gorkemguven/LattePanda-Mu-Lite-Custom-Carrier/bom.csv

Designator | Footprint | Quantity | Value | LCSC Part #
A1 | LattePanda_Module_H8.0mm_Horizontal | 1 | LattePanda_Mu
BT1 | Battery_Holder_CR1220_S8411-45R | 1 | Battery_Cell
C17, C18, C19, C20, C21, C22, C23, C24, C25, C26, C27, C28, C29, C33, C34, C35, C36, C37, C38, C39, C40, C41, C42, C43, C45, C48, C52, C54, C58, C60, C84 | 0402 | 31 | 100nF/50V
C30, C31, C32, C64, C65, C67, C68, C74, C75, C76, C77, C80, C81, C82, C83 | 0603 | 15 | 22uF/10V
C44, C51, C53, C57, C59 | 0402 | 5 | 10uF/50V
C46, C47, C73 | 0402 | 3 | 12pF/50V
C49, C50, C55, C56 | 0402 | 4 | 220nF/50V
C61, C66, C69 | 0402 | 3 | 1uF/16V
C70, C71 | 0603 | 2 | 100nF/50V
C78, C79 | 0603 | 2 | 100nF/10V
D1, D2, D3 | 0402 | 3 | ESD5V0B03
D10, D11, D21, D25, D5, D6, D7, D8 | 0402 | 8 | ESD9B5.0ST5G
D12, D13, D14 | 0402 | 3 | D_Zener
D15, D16, D17, D18, D19, D20 | D_SMA | 6 | D_Schottky
D22 | 0603 | 1 | LED
D24 | D_SOD-323 | 1 | 3V3 Izt=5mA
D26, D4 | D_SOD-323 | 2 | 1N5819WS
D9 | 0603 | 1 | LED_G
F1 | 0603 | 1 | 6V/50mA
F2, F3, F4, F5 | 0805 | 4 | 6V/1A
J1, J10, J11, J14, J8 | PinHeader_1x03_P2.54mm_Vertical | 5 | Conn_01x03_Pin
J12, J13, J19, J20, J21, J7, J9 | PinHeader_1x04_P2.54mm_Vertical | 7 | Conn_01x04_Pin
J15 | PCIe_M.2_Connectors_P=0.5mm_H=4.2mm_KeyM | 1 | Bus_M.2_Socket_M
J16 | PCIe_M.2_Connectors_P=0.5mm_H=4.2mm_KeyE | 1 | Bus_M.2_Socket_E
J17 | DC_Jack_DC007B_30V_10A | 1 | Barrel_Jack_Switch
J18 | USB_C_Receptacle_G-Switch_GT-USB-7010ASV | 1 | USB_C_Receptacle_USB2.0_16P
J3 | HDMI_A_Molex_208658-1001_Horizontal | 1 | HDMI_A
J4 | USB3_A_Molex_48406-0001_Horizontal_Stacked | 1 | USB3_A_Stacked
J5 | USB_A_CUI_UJ2-ADH-TH_Horizontal_Stacked | 1 | USB_A_Stacked
J6 | RJ45_UDE_RB1-125B8G1A | 1 | RJ45_RB1-125B8G1A
L1, L2 | L_Sunlord_SWPA4020S | 2 | 2.2uH/4.3A
M1 | JST_PH_B4B-PH-K_1x04_P2.00mm_Vertical | 1 | Fan_4pin
Q1, Q8 | SOT-23 | 2 | 2N7002
Q2, Q3, Q4 | SOT-23 | 3 | 2SK3018
R1, R11, R37, R47 | 0402 | 4 | 1K/1%
R10, R13, R14, R16, R17, R24, R25, R7, R8, R9 | 0402 | 10 | 470R/1%
R15, R18, R19, R3, R5, R52, R53 | 0402 | 7 | 2.2K/1%
R2, R20, R21, R34, R35, R36, R49, R58, R78, R79 | 0402 | 10 | 10K/1%
R22 | 0603 | 1 | 2.49K/1%
R23, R4 | 0402 | 2 | 1M/1%
R27, R29, R32, R33 | 0402 | 4 | 0R/1%
R43 | 0402 | 1 | 56K/1%
R46, R51, R76, R77 | 0402 | 4 | 100K/1%
R48, R55, R69 | 0402 | 3 | 100R/1%
R57 | 0402 | 1 | 75K/1%
R59, R6, R68 | 0402 | 3 | 21.5K/1%
R60, R72 | 0402 | 2 | 4.7K/1%
SW1, SW2 | SW_Push_6x6x6 | 2 | SW_Push
TP10, TP11, TP12, TP13, TP2, TP3, TP4, TP5, TP6, TP7 | TestPoint_Pad_D1.5mm | 10 | TestPoint
U1, U2, U3, U4, U5 | Diodes_UDFN-10_1.0x2.5mm_P0.5mm | 5 | D3V3XA4B10LP
U10, U11, U12, U17, U9 | Diodes_UDFN-10_1.0x2.5mm_P0.5mm | 5 | ULC0524P
U14 | ESSOP-10-1EP_3.9x5mm_P1.0mm_EP3.2x2.3 | 1 | USB PD等快充协议受电芯片-CH224K-ESSOP10
U15, U16 | TSOT-23-6 | 2 | LM2734X
U6 | QFN-32-1EP_4x4mm_P0.4mm_EP2.65x2.65mm | 1 | RTL8111H-CG-RH
Y1 | Crystal_SMD_3225-4Pin_3.2x2.5mm | 1 | 25MHz
