gorkemguven/LattePanda-Mu-Lite-Custom-Carrier/LattePandaMu_carrier_custom_Sch.pdf

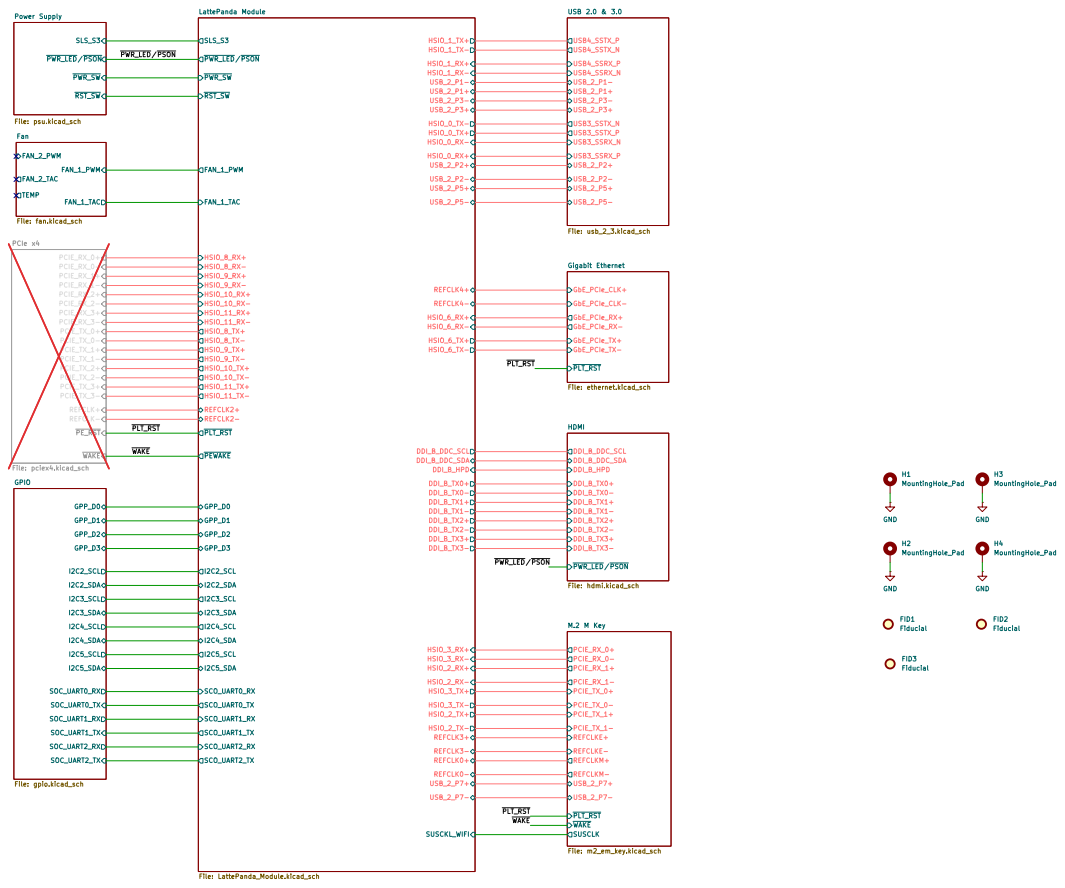
[picture p8: page 1]

Size: A2 | Rev: 1
KiCad E.D.A. 10.0.1 | Id: 1/10

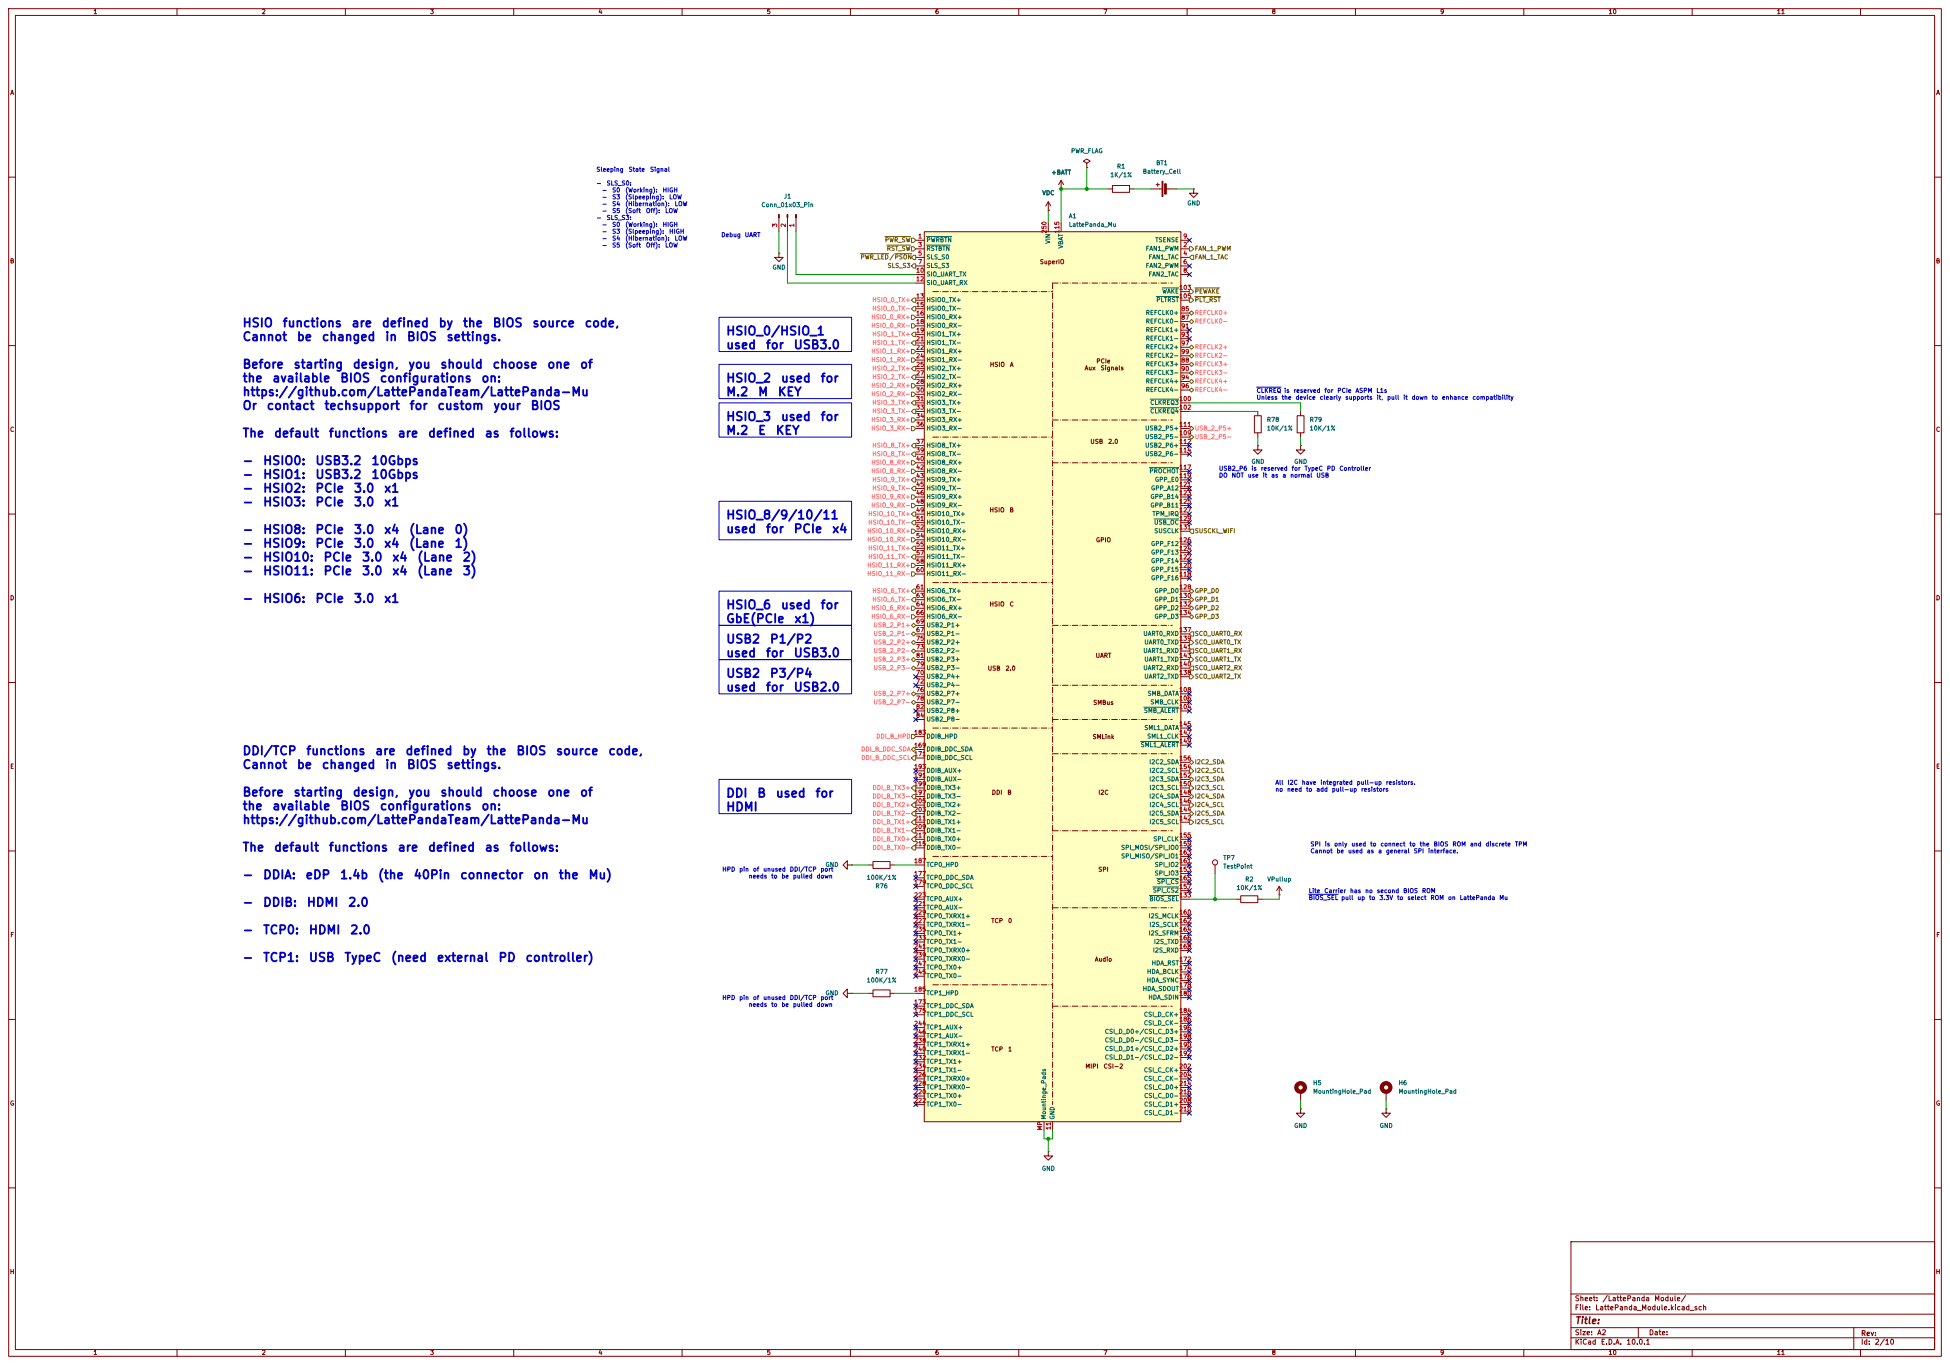
[picture p9: page 2]

Sleeping State Signal - SLS_S0: - S0 (Working): HIGH - S3 (Slpeeping): LOW - S4 (Hibernation): LOW - S5 (Soft Off): LOW - SLS_S3: - S0 (Working): HIGH - S3 (Slpeeping): HIGH - S4 (Hibernation): LOW - S5 (Soft Off): LOW HSIO functions are defined by the BIOS source code,

CLKREQ is reserved for PCIe ASPM L1s Unless the device clearly supports it, pull it down to enhance compatibility +BATT VDC

Cannot be changed in BIOS settings.

Before starting design, you should choose one of
the available BIOS configurations on:
https://github.com/LattePandaTeam/LattePanda-Mu
Or contact techsupport for custom your BIOS

HSIO A HSIO B HSIO C USB 2.0 DDI B

The default functions are defined as follows: - HSIO0: USB3.2 10Gbps - HSIO1: USB3.2 10Gbps - HSIO2: PCIe 3.0 x1 - HSIO3: PCIe 3.0 x1 - HSIO8: PCIe 3.0 x4 (Lane 0) - HSIO9: PCIe 3.0 x4 (Lane 1) - HSIO10: PCIe 3.0 x4 (Lane 2) - HSIO11: PCIe 3.0 x4 (Lane 3) - HSIO6: PCIe 3.0 x1

USB2_P6 is reserved for TypeC PD Controller DO NOT use it as a normal USB

HPD pin of unused DDI/TCP port needs to be pulled down DDI/TCP functions are defined by the BIOS source code,

All I2C have integrated pull-up resistors. no need to add pull-up resistors SPI is only used to connect to the BIOS ROM and discrete TPM

The default functions are defined as follows: - DDIA: eDP 1.4b (the 40Pin connector on the Mu) - DDIB: HDMI 2.0 - TCP0: HDMI 2.0 - TCP1: USB TypeC (need external PD controller)

Cannot be used as a general SPI interface.

BIOS_SEL pull up to 3.3V to select ROM on LattePanda Mu HPD pin of unused DDI/TCP port needs to be pulled down

Lite Carrier has no second BIOS ROM

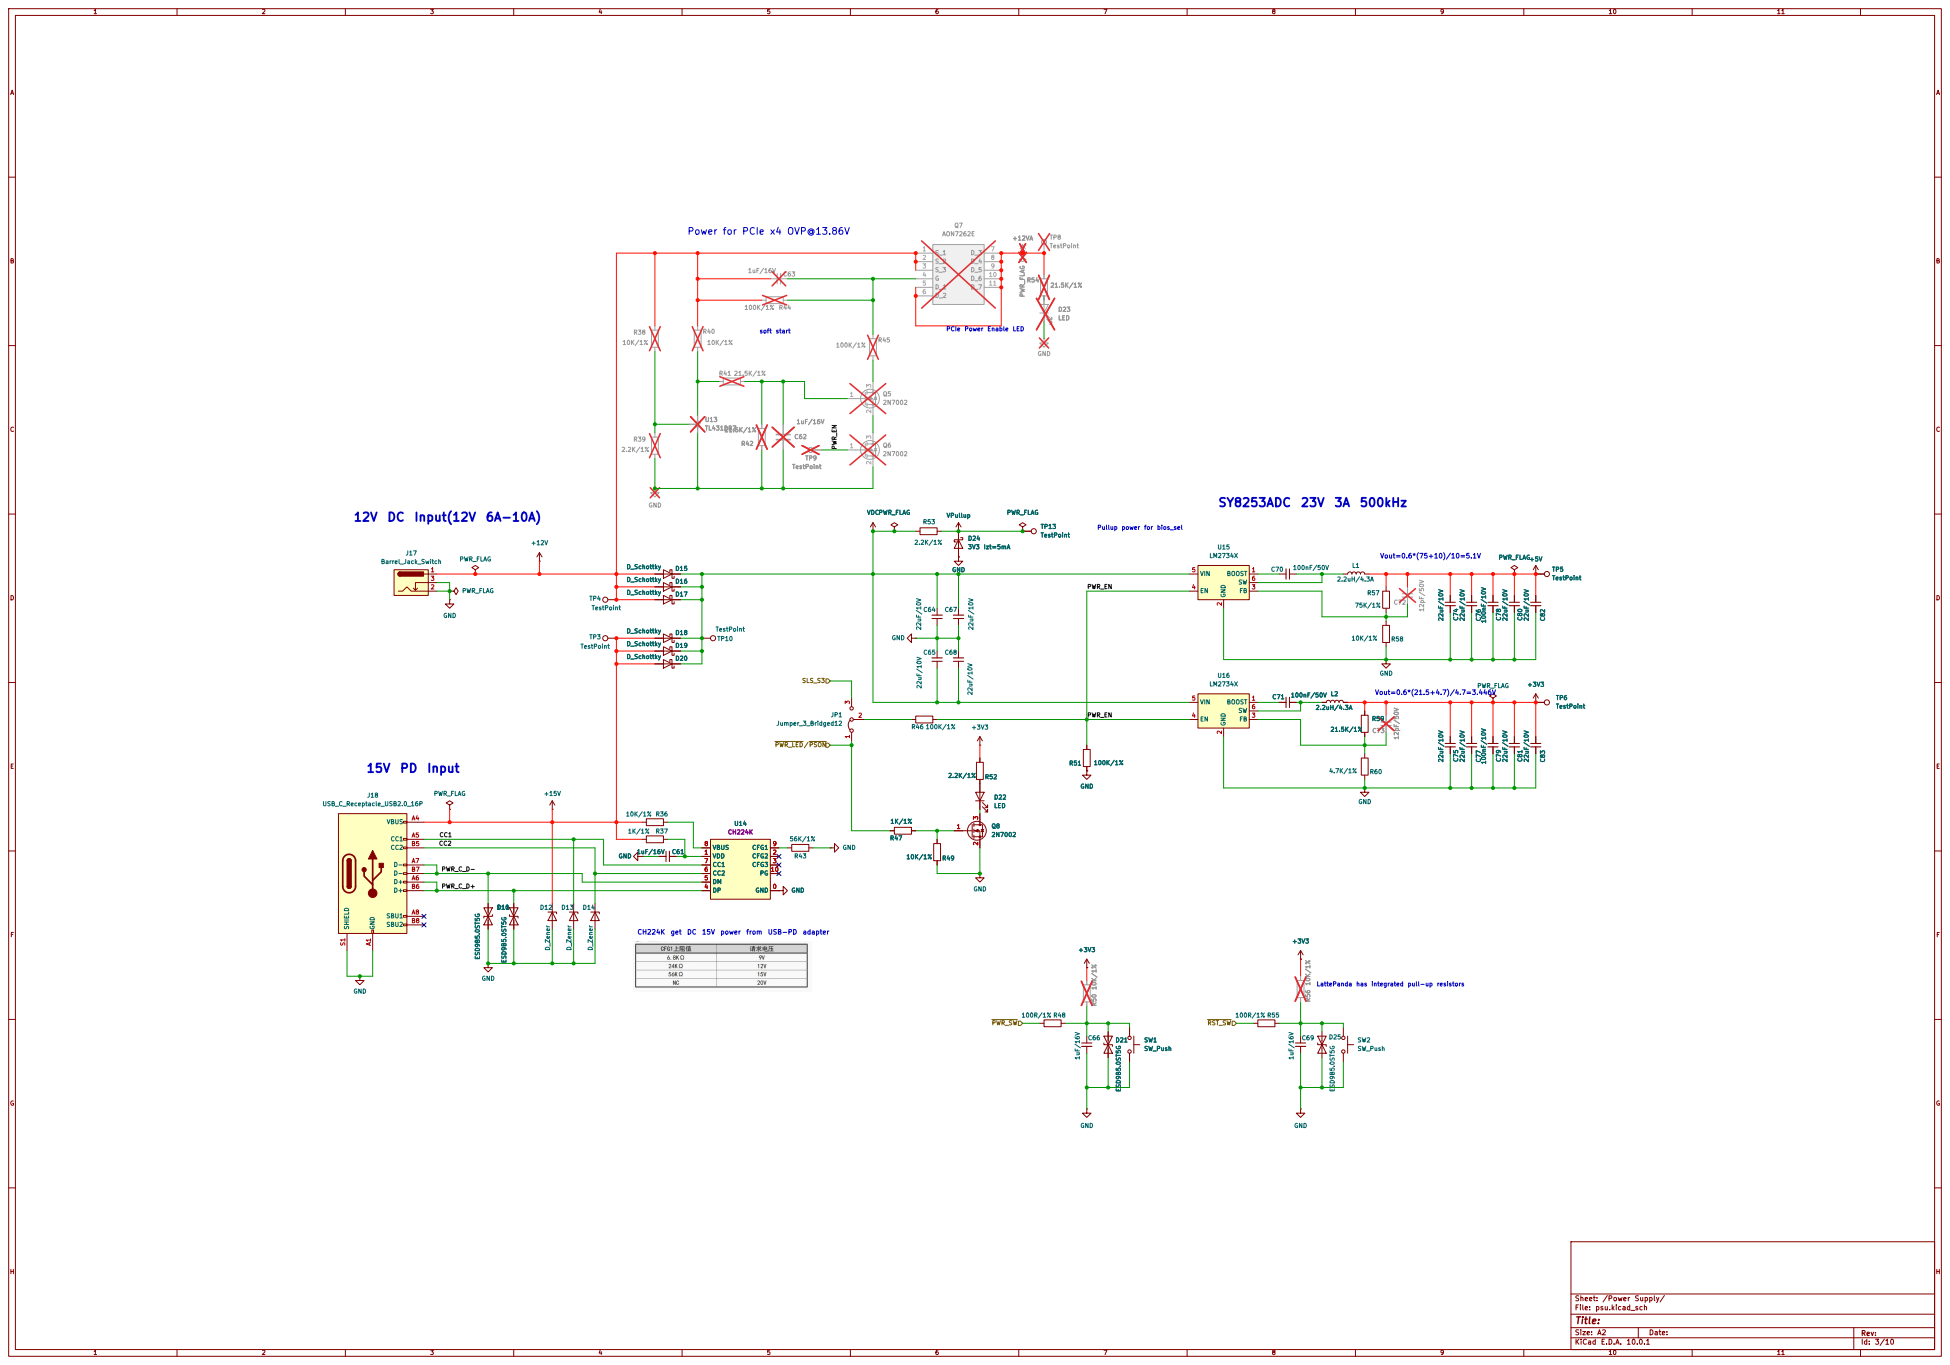
[picture p10: page 3]

Power for PCIe x4 OVP@13.86V

PCIe Power Enable LED 15V PD Input

LattePanda has integrated pull-up resistors SY8253ADC 23V 3A 500kHz

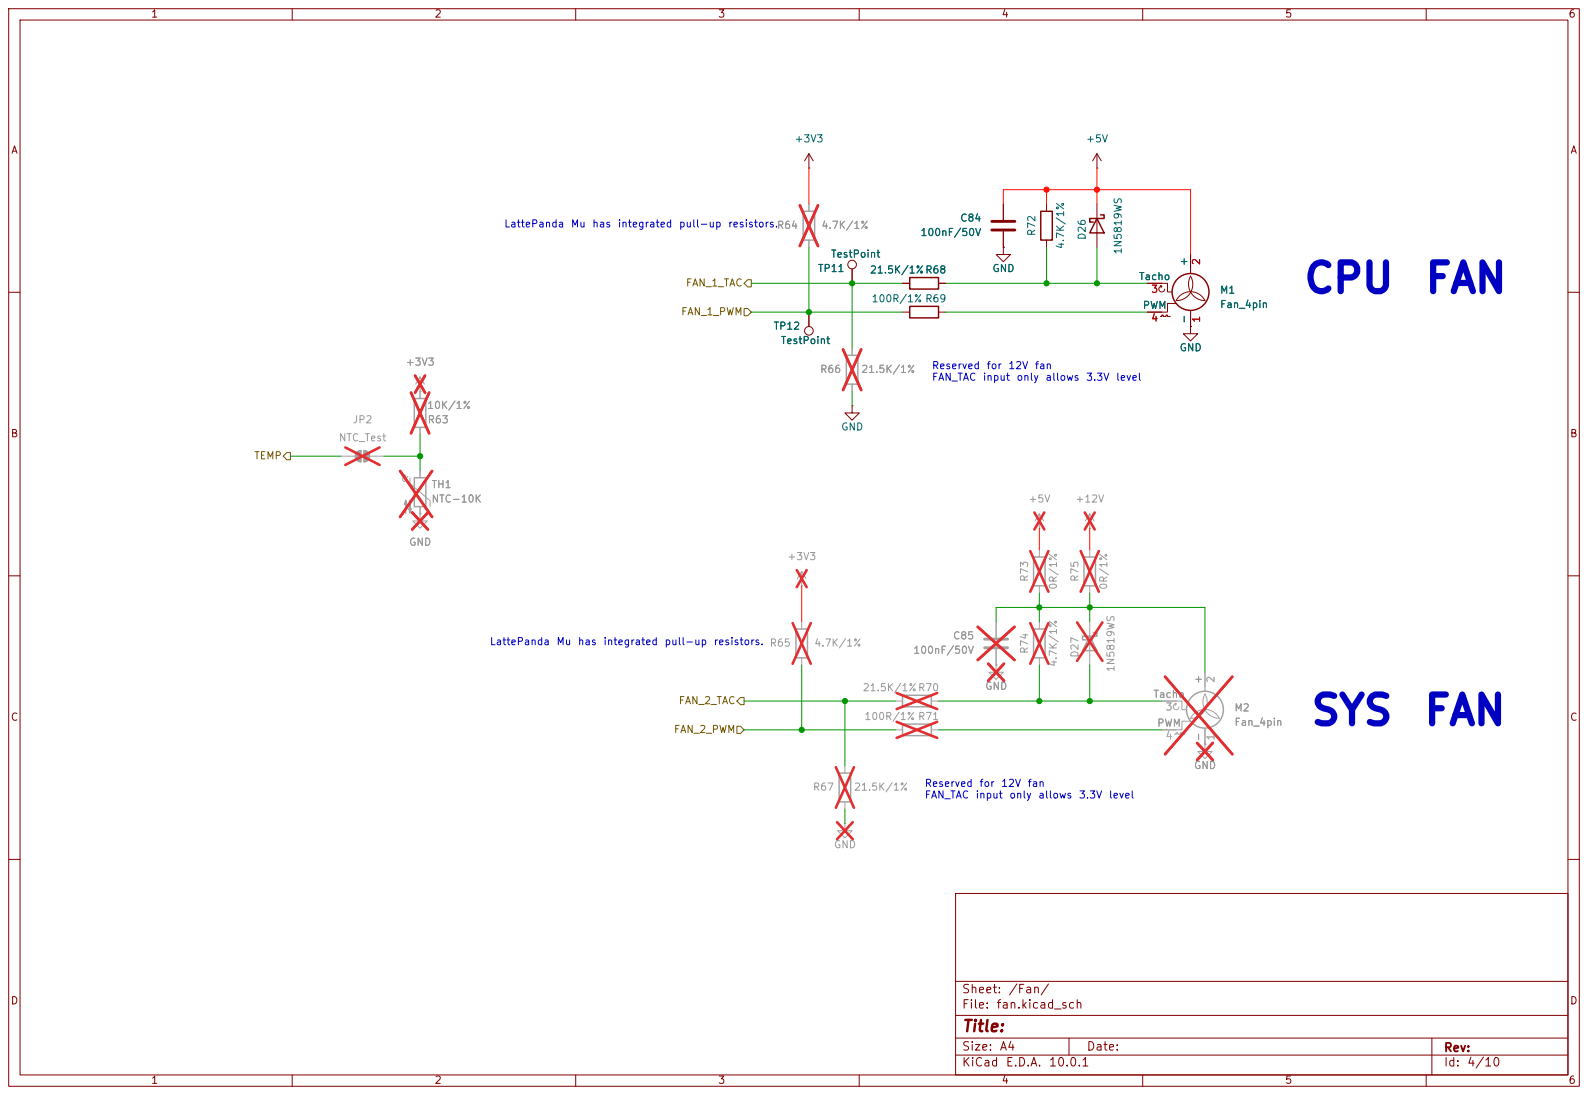
[picture p11: page 4]

Fan_4pin +5V GND
4 GND
FAN_TAC input only allows 3.3V level Reserved for 12V fan

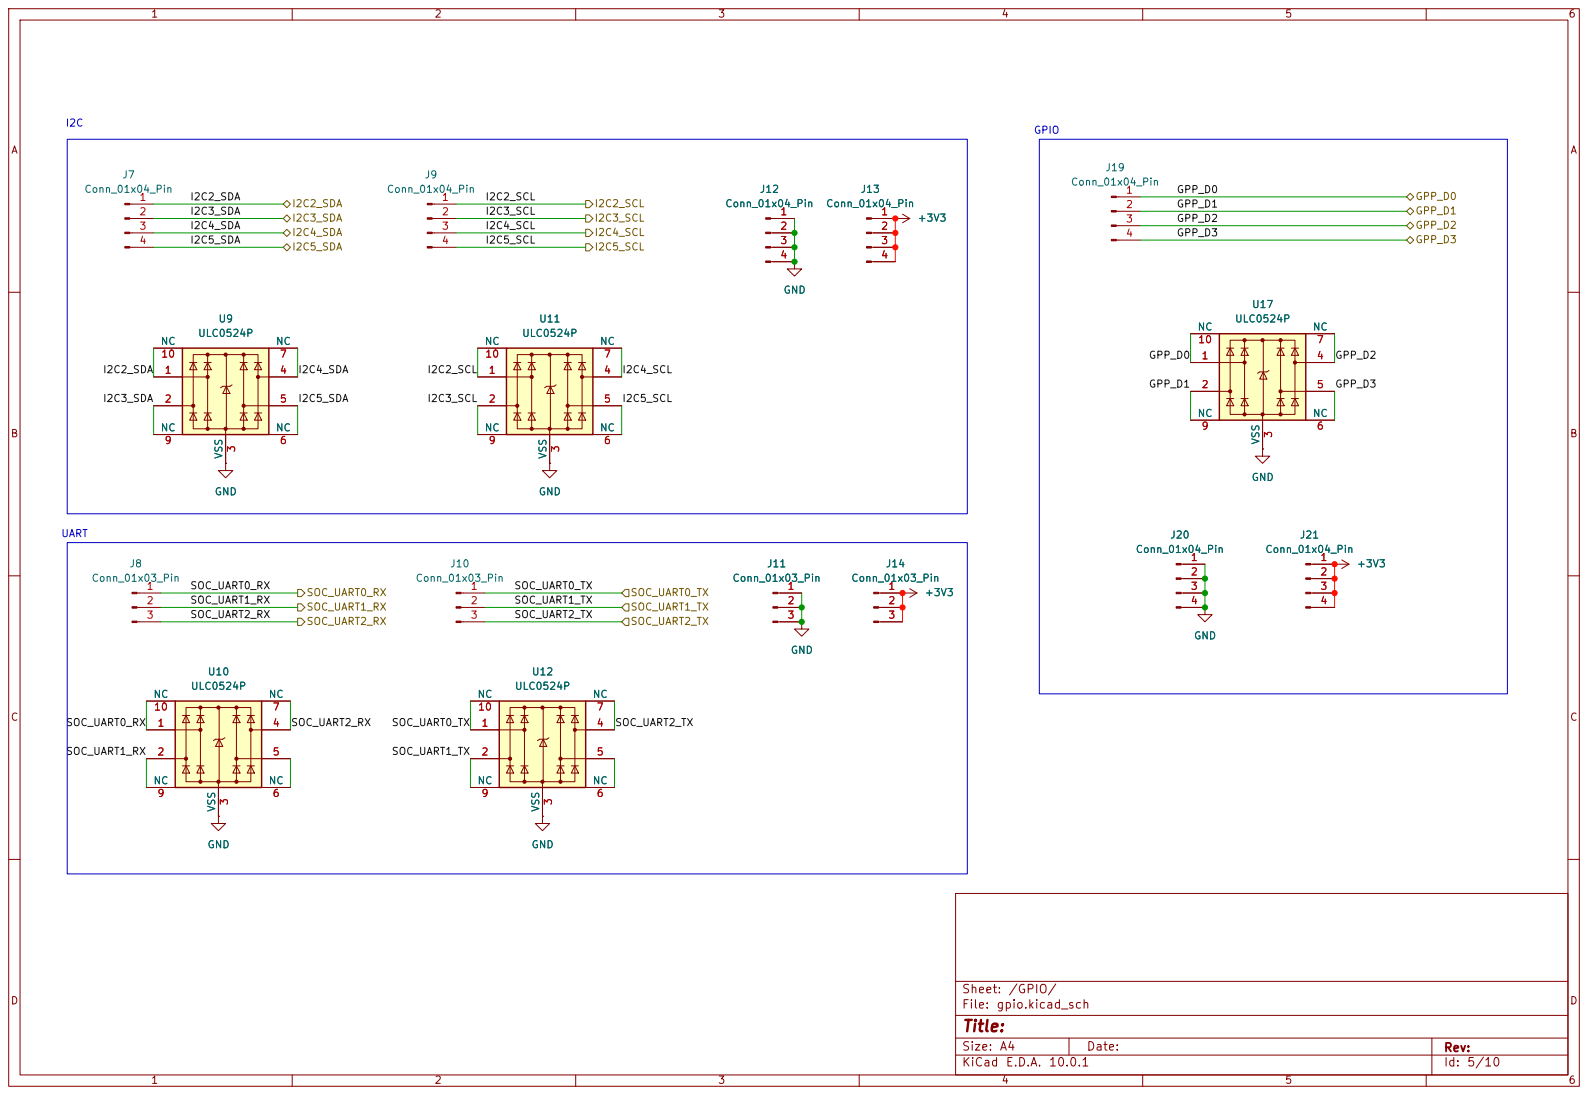
[picture p12: page 5]

4 | 5NC | +3V3 U17 ULC0524P

9NC 9NC 1 1 | 6NC 6NC 4 4
7 NC

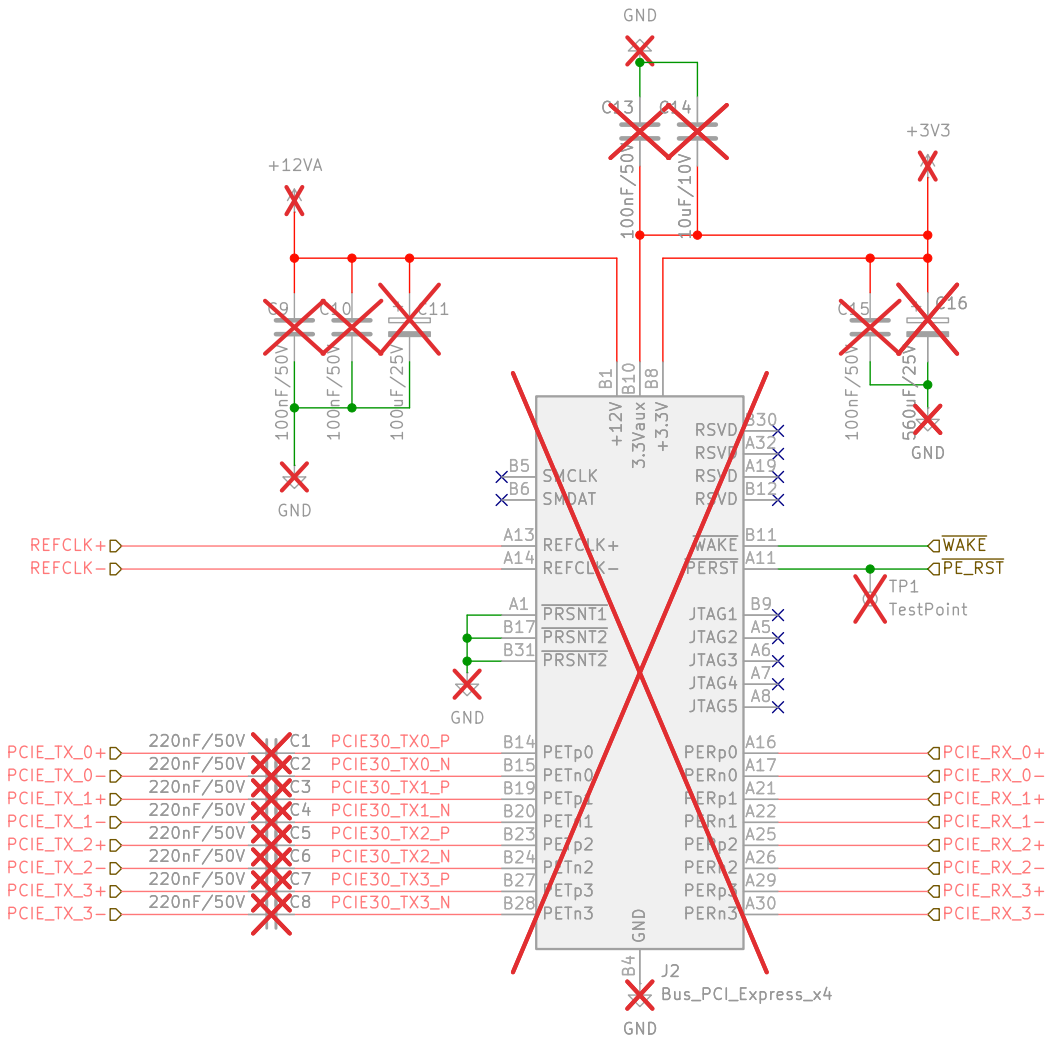
[picture p13: page 6]

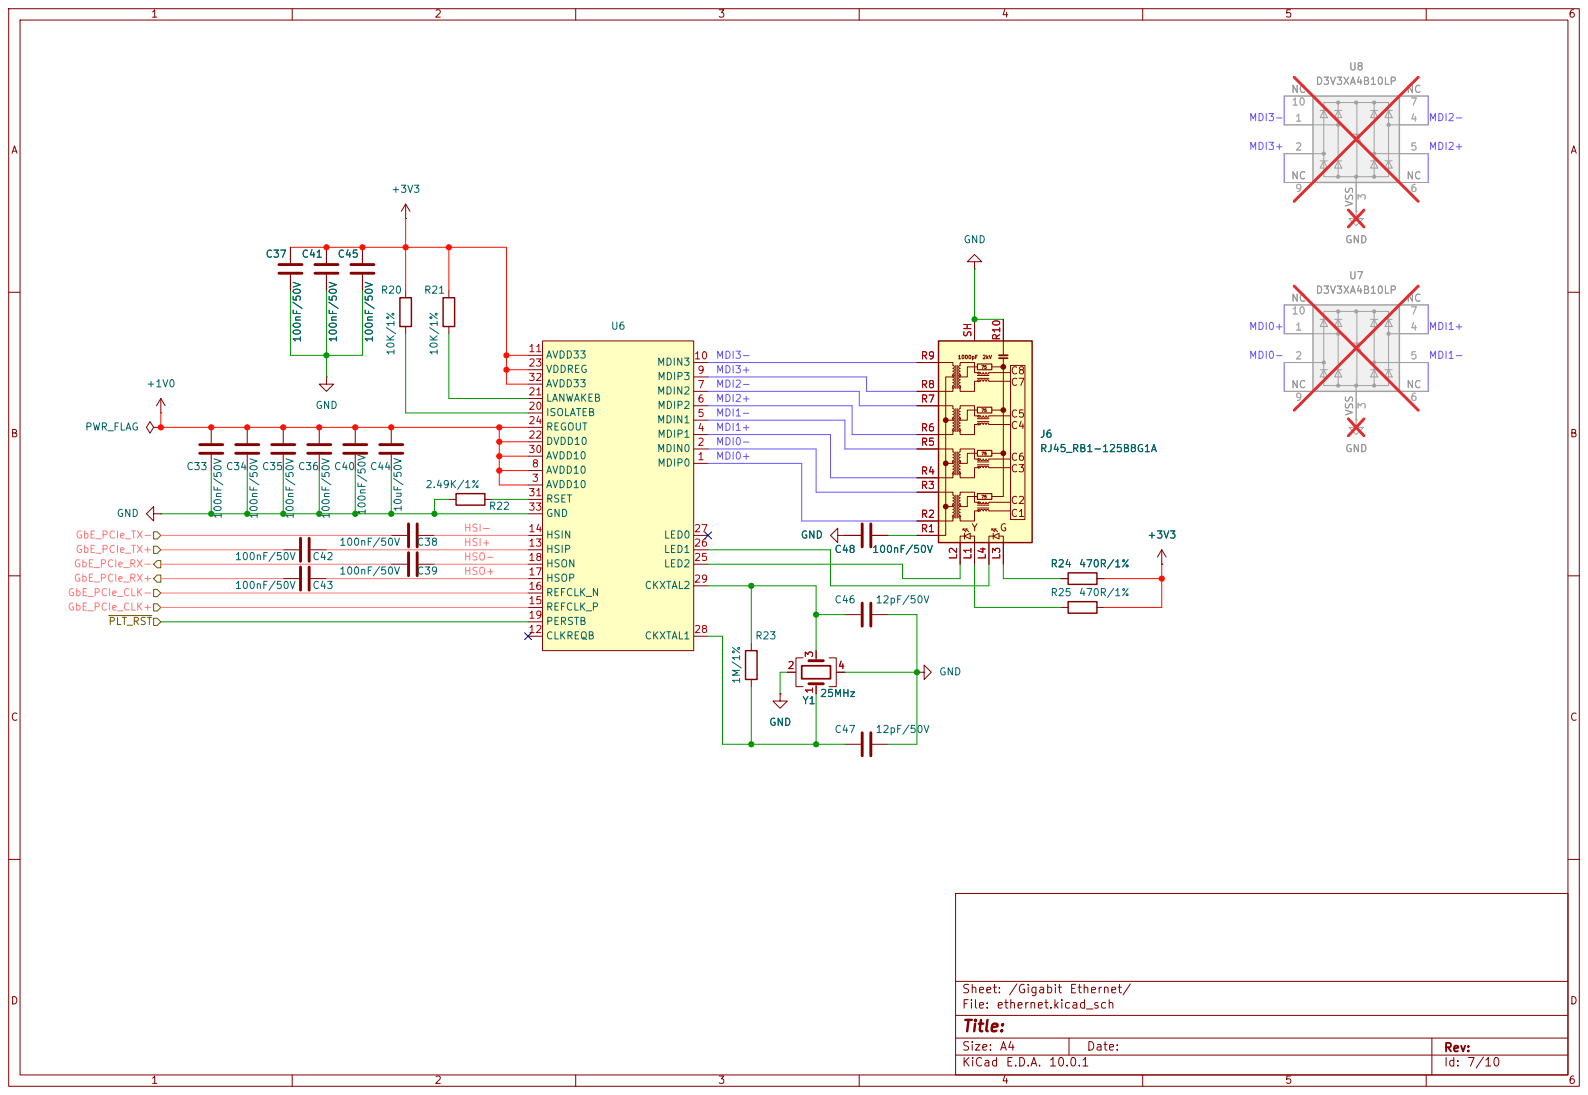
[picture p14: page 7]

MDI1- | 75

100nF/50V | | C39 HSO+

HSO-

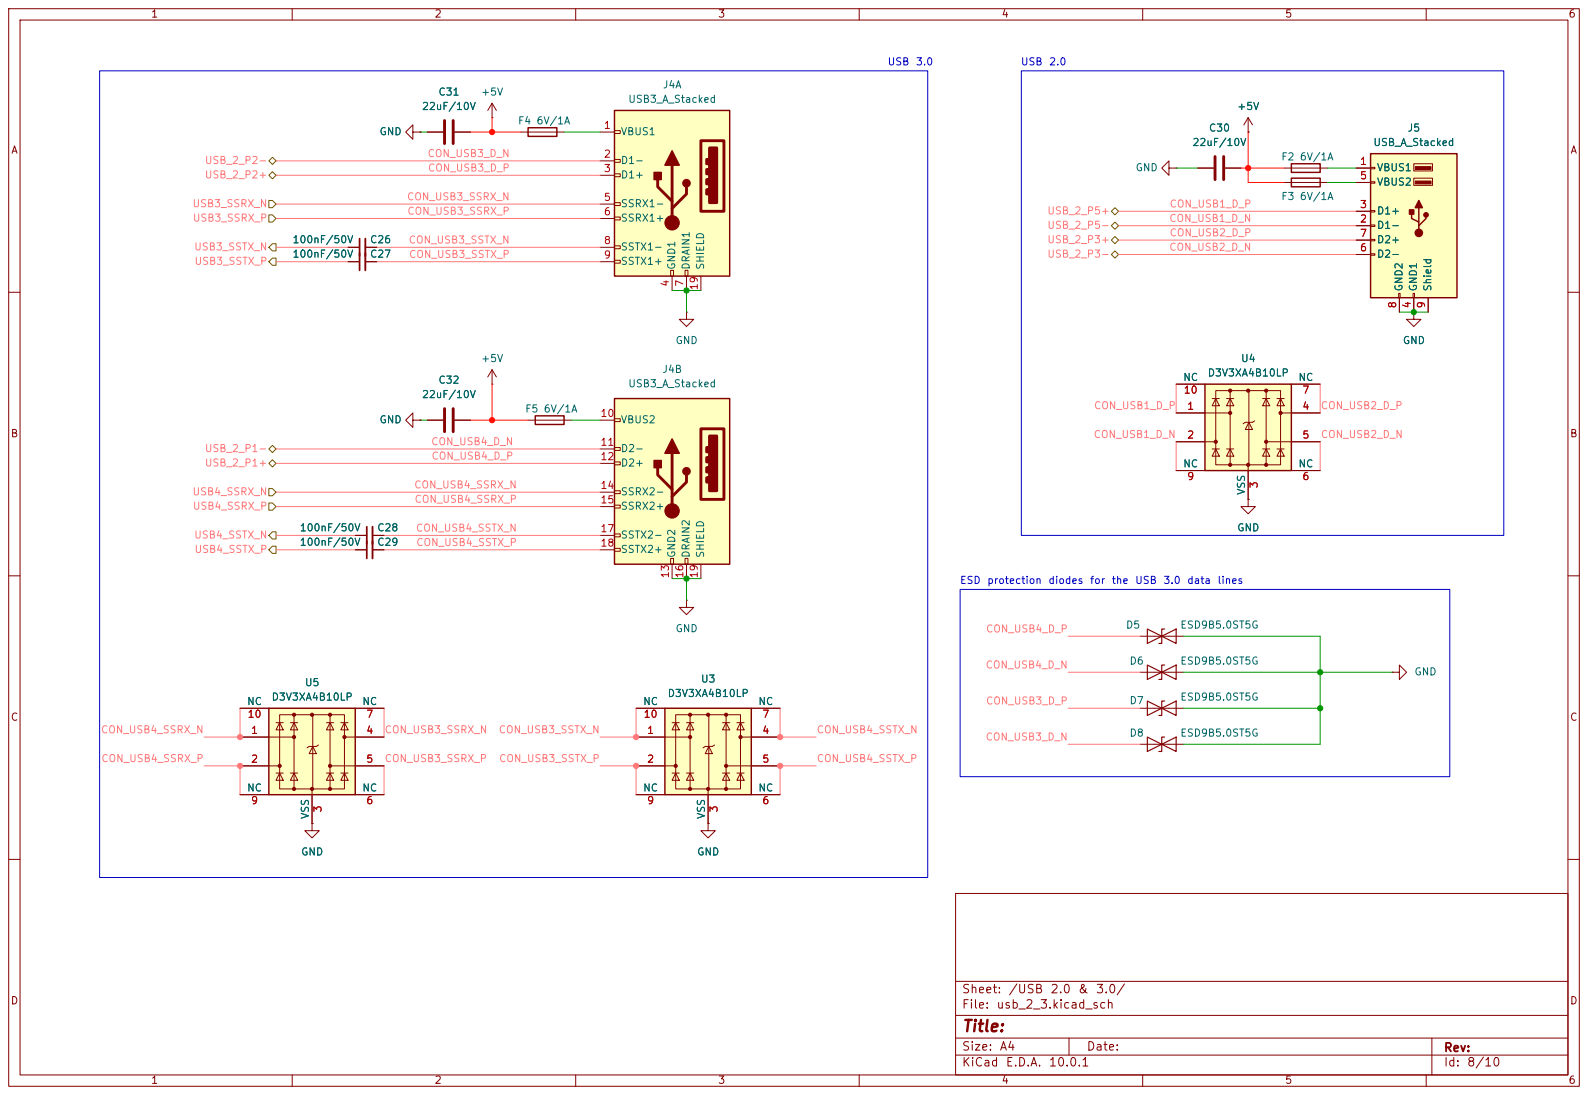
[picture p15: page 8]

ESD protection diodes for the USB 3.0 data lines+5V C30

9NC 9NC 1 1 | 6NC 6NC 4 4
7 NC

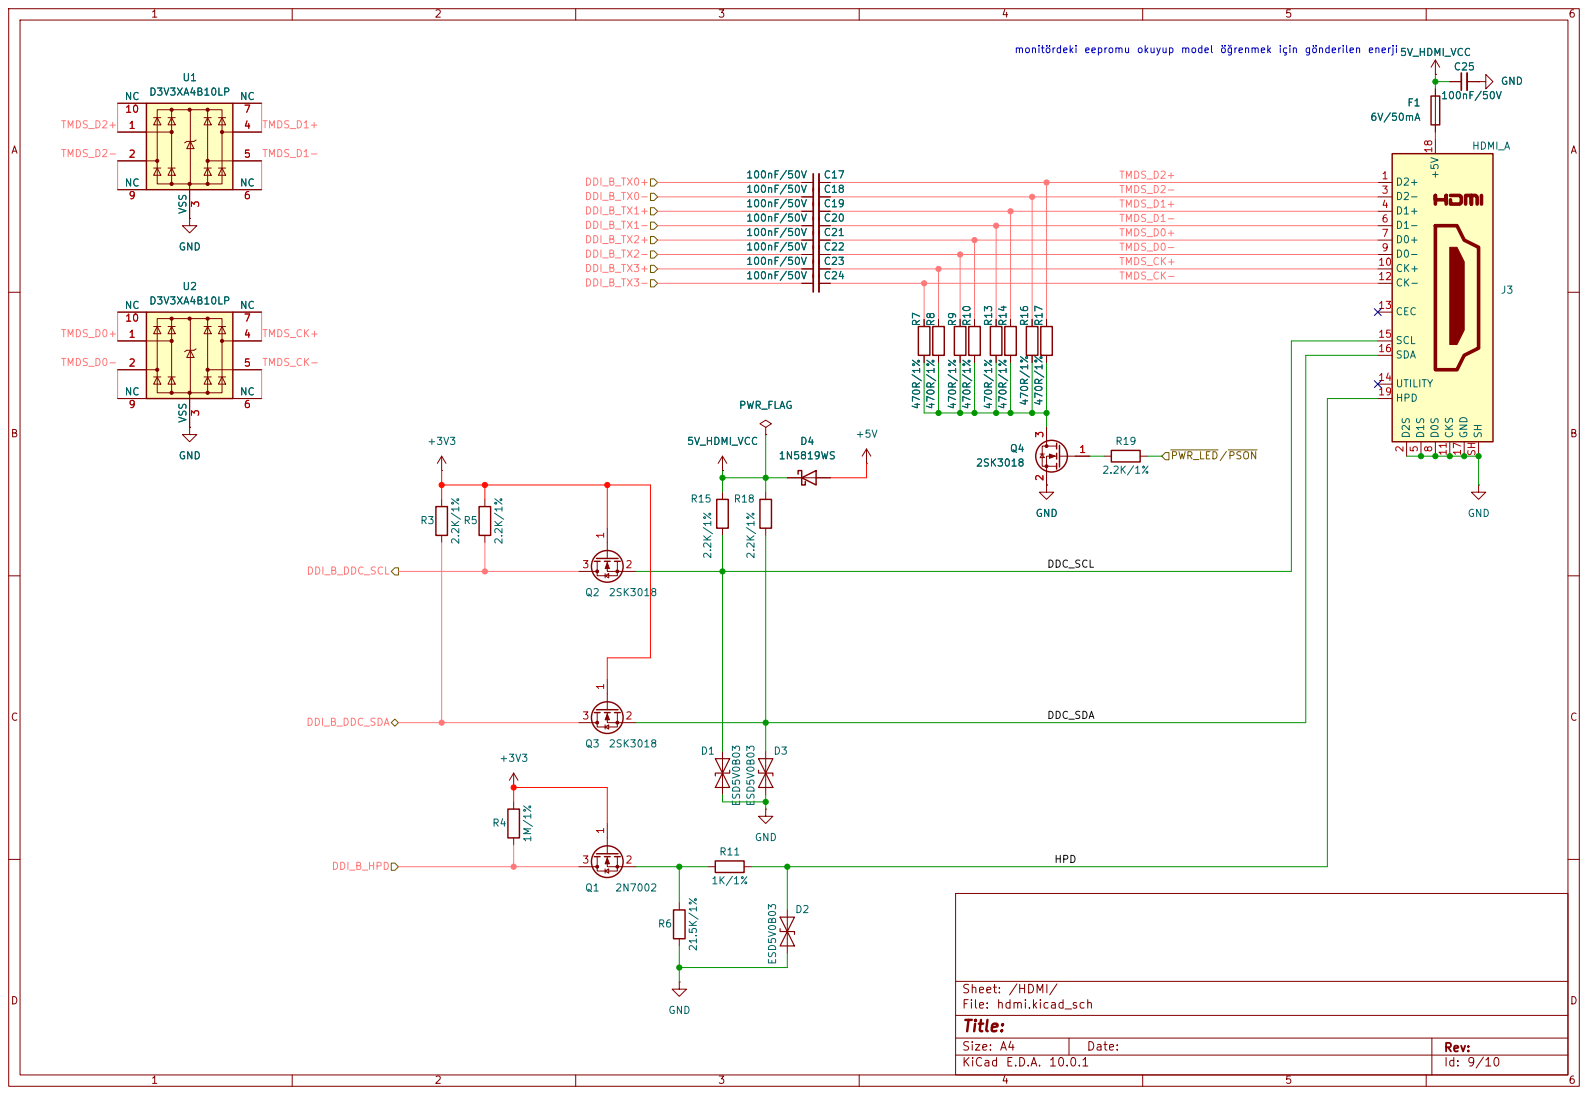
[picture p16: page 9]

TMDS_D0+ monitördeki eepromu okuyup model öğrenmek için gönderilen enerji R14 470R/1% R16 470R/1% R13 470R/1%

7 NC
1 1 | 4 4

TMDS_D2-
TMDS_D1+
TMDS_D1-

8 D0- 9 CK+ 10 CKS 11 CK- 12 CEC 13 UTILITY 14

TMDS_CK+
TMDS_CK-

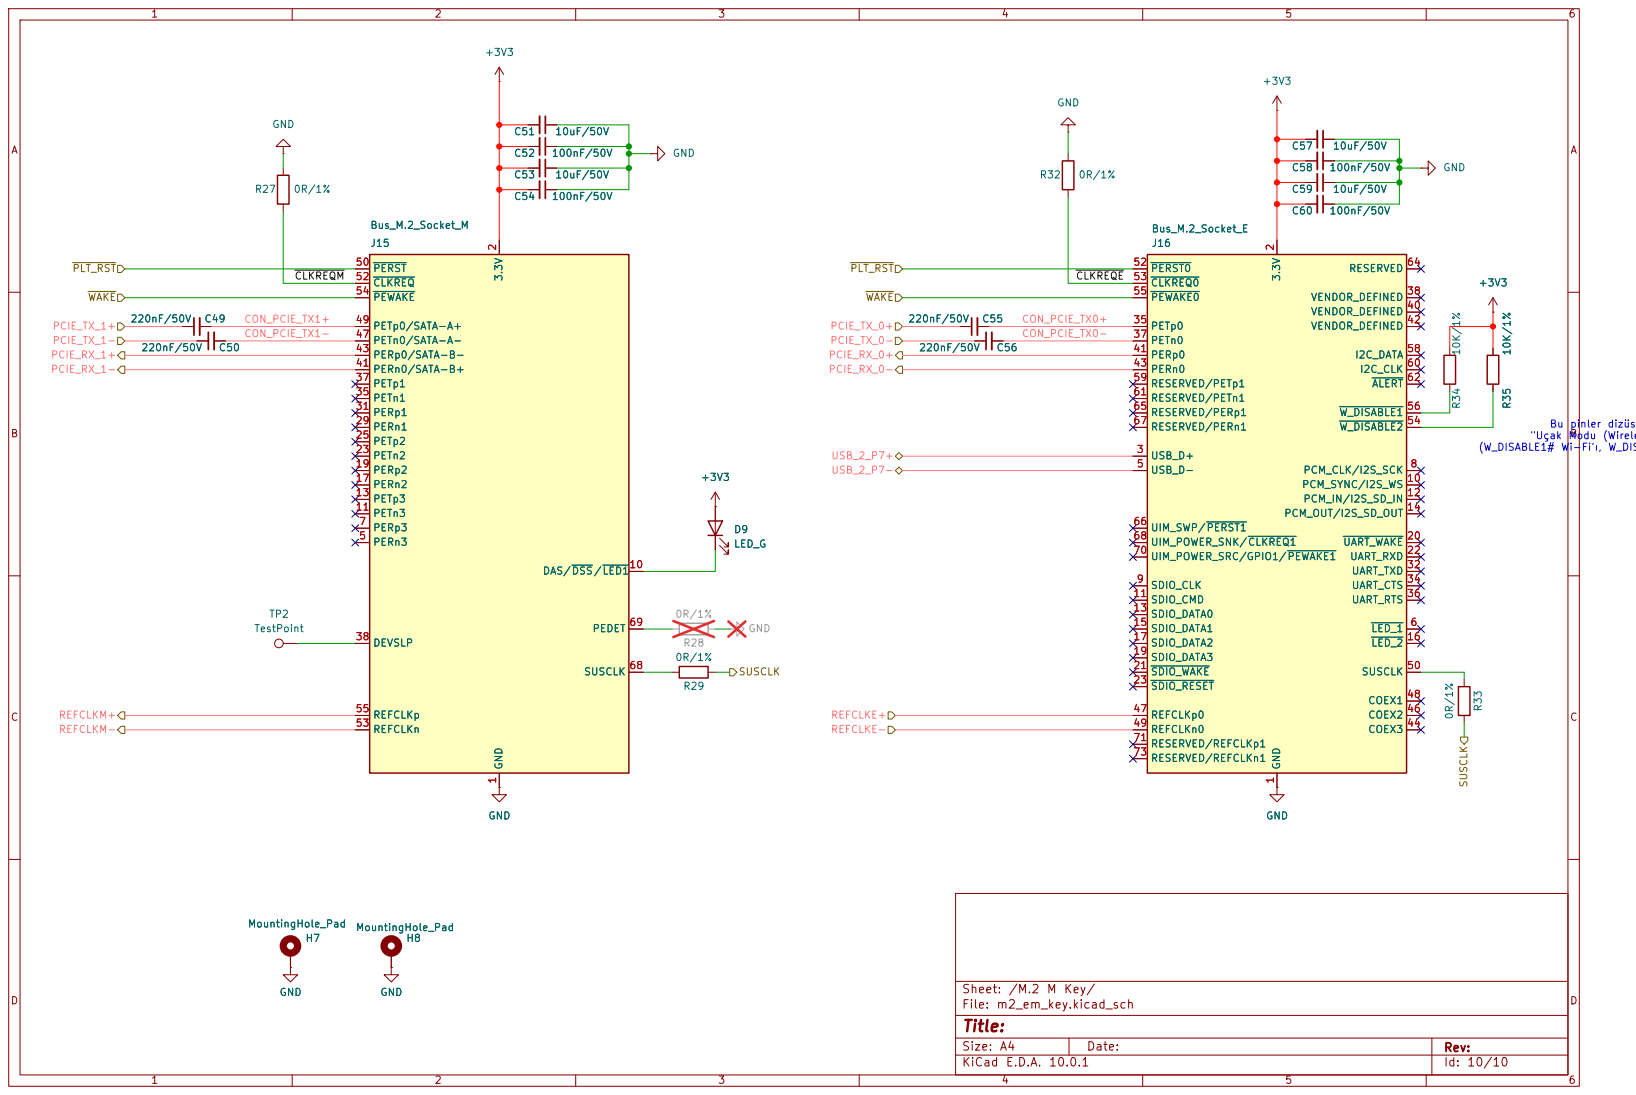
[picture p17: page 10]

1 3.3V 2 PERn3 5 PERp3 7 DAS/DSS/LED110 PETn3 11 PETp3 13 PERn2 17 PERp2 19 PETn2 23 PETp2 25 PERn1 29 PERp1 31 PETn1 35 PETp1 37 DEVSLP 38 PERn0/SATA-B+ 41 PERp0/SATA-B- 43 PETn0/SATA-A- 47 PETp0/SATA-A+ 49 PERST 50 CLKREQ 52 REFCLKn 53 PEWAKE 54 REFCLKp 55

(W_DISABLE1# Wi-Fi'ı, W_DISABLE2# ise Bluetooth'u kapatır). R35 10K/1% +3V3 D9

Bu pinler dizüstü bilgisayarlardaki
"Uçak Modu (Wireless Disable)" pinleridir
