gorkemguven/LattePanda-Mu-Lite-Custom-Carrier/LattePandaMu_carrier_custom.kicad_pcb

## KiCad design LattePandaMu_carrier_custom.kicad_pcb (2026-11-01)

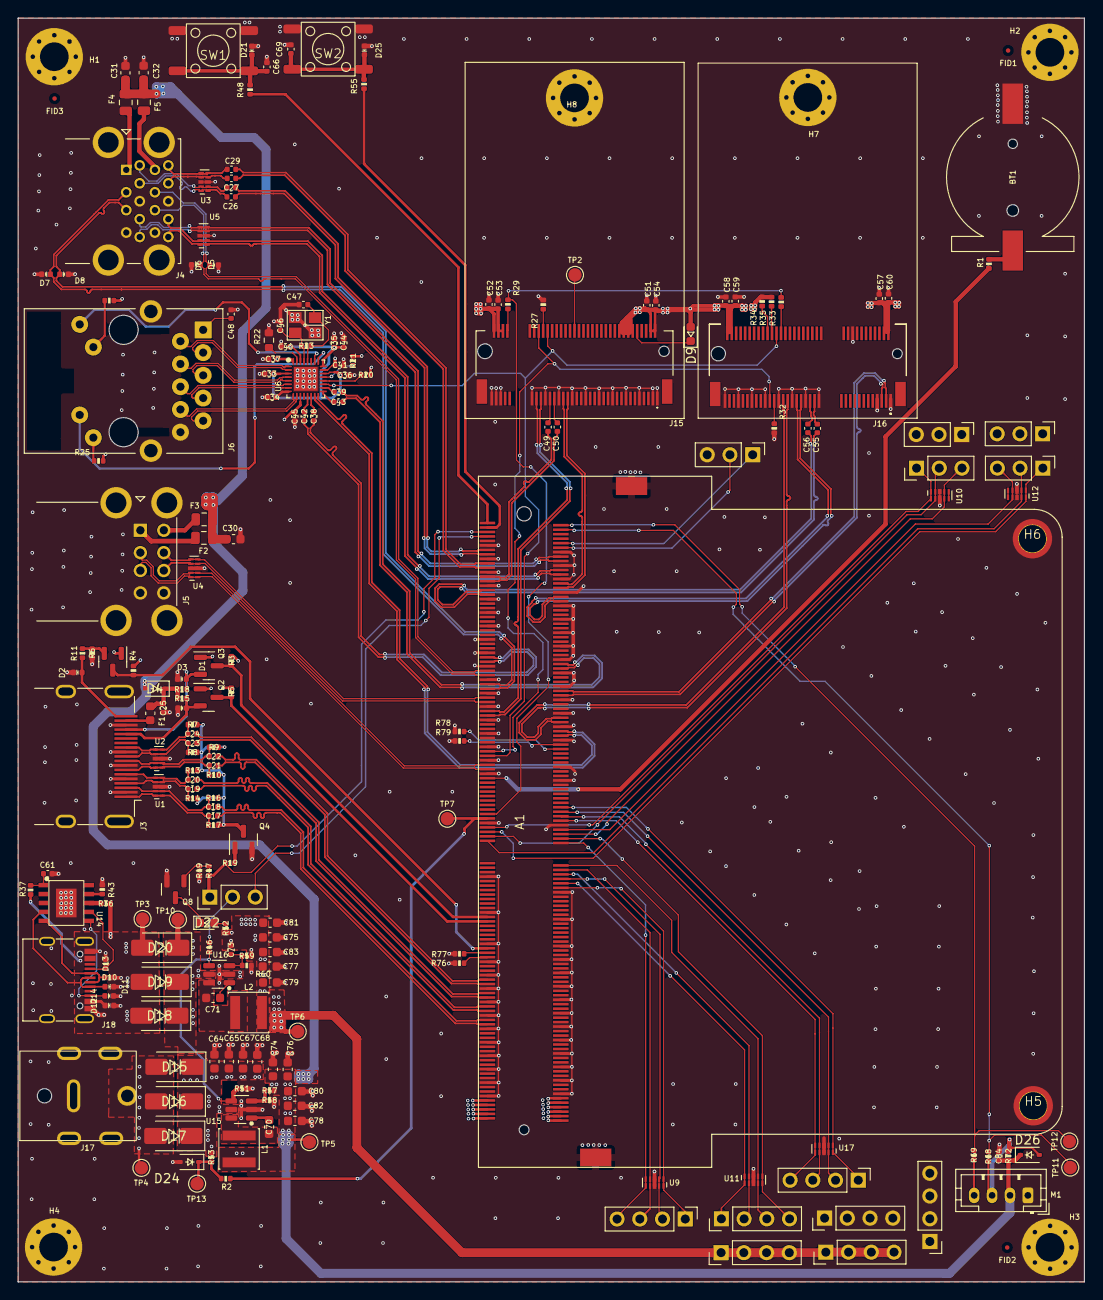
[picture p18: board LattePandaMu_carrier_custom.kicad_pcb from above]

Board: 4 copper layers, 119.1 x 141.2 mm, 216 parts (0 on the bottom side), 173 nets.

Parts:
A1: LattePanda_Mu; LattePanda_Module_H8.0mm_Horizontal
BT1: Battery_Cell; Battery_Holder_CR1220_S8411-45R
C17, C18, C19, C20, C21, C22, C23, C24, C25, C26, C27, C28, C29, C33, C34, C35, C36, C37, C38, C39, C40, C41, C42, C43, C45, C48, C52, C54, C58, C60, C84: 100nF/50V; C_0402_1005Metric
C30, C31, C32, C64, C65, C67, C68, C74, C75, C76, C77, C80, C81, C82, C83: 22uF/10V; C_0603_1608Metric
C44, C51, C53, C57, C59: 10uF/50V; C_0402_1005Metric
C46, C47, C73: 12pF/50V; C_0402_1005Metric
C49, C50, C55, C56: 220nF/50V; C_0402_1005Metric
C61, C66, C69: 1uF/16V; C_0402_1005Metric
C70, C71: 100nF/50V; C_0603_1608Metric
C78, C79: 100nF/10V; C_0603_1608Metric
D1, D2, D3: ESD5V0B03; D_0402_1005Metric
D4, D26: 1N5819WS; D_SOD-323
D5, D6, D7, D8, D10, D11, D21, D25: ESD9B5.0ST5G; D_0402_1005Metric
D9: LED_G; LED_0603_1608Metric
D12, D13, D14: D_Zener; D_0402_1005Metric
D15, D16, D17, D18, D19, D20: D_Schottky; D_SMA
D22: LED; LED_0603_1608Metric
D24: 3V3 Izt=5mA; D_SOD-323
F1: 6V/50mA; C_0603_1608Metric
F2, F3, F4, F5: 6V/1A; Fuse_0805_2012Metric
FID1, FID2, FID3: Fiducial; Fiducial_0.5mm_Mask1mm
H1, H2, H3, H4, H7, H8: MountingHole_Pad; MountingHole_3.2mm_M3_Pad_Via
H5, H6: MountingHole_Pad; MountingHole_3mm_M2_Pad_TopOnly
J1, J8, J10, J11, J14: Conn_01x03_Pin; PinHeader_1x03_P2.54mm_Vertical
J3: HDMI_A; HDMI_A_Molex_208658-1001_Horizontal
J4: USB3_A_Stacked; USB3_A_Molex_48406-0001_Horizontal_Stacked
J5: USB_A_Stacked; USB_A_CUI_UJ2-ADH-TH_Horizontal_Stacked
J6: RJ45_RB1-125B8G1A; RJ45_UDE_RB1-125B8G1A
J7, J9, J12, J13, J19, J20, J21: Conn_01x04_Pin; PinHeader_1x04_P2.54mm_Vertical
J15: Bus_M.2_Socket_M; PCIe_M.2_Connectors_P=0.5mm_H=4.2mm_KeyM
J16: Bus_M.2_Socket_E; PCIe_M.2_Connectors_P=0.5mm_H=4.2mm_KeyE
J17: Barrel_Jack_Switch; DC_Jack_DC007B_30V_10A
J18: USB_C_Receptacle_USB2.0_16P; USB_C_Receptacle_G-Switch_GT-USB-7010ASV
JP1: Jumper_3_Bridged12; PinHeader_1x03_P2.54mm_Vertical
L1, L2: 2.2uH/4.3A; L_Sunlord_SWPA4020S
M1: Fan_4pin; JST_PH_B4B-PH-K_1x04_P2.00mm_Vertical
Q1, Q8: 2N7002; SOT-23
Q2, Q3, Q4: 2SK3018; SOT-23
R1, R11, R37, R47: 1K/1%; R_0402_1005Metric
R2, R20, R21, R34, R35, R36, R49, R58, R78, R79: 10K/1%; R_0402_1005Metric
R3, R5, R15, R18, R19, R52, R53: 2.2K/1%; R_0402_1005Metric
R4, R23: 1M/1%; R_0402_1005Metric
R6, R59, R68: 21.5K/1%; R_0402_1005Metric
R7, R8, R9, R10, R13, R14, R16, R17, R24, R25: 470R/1%; R_0402_1005Metric
R22: 2.49K/1%; R_0603_1608Metric
R27, R29, R32, R33: 0R/1%; R_0402_1005Metric
R43: 56K/1%; R_0402_1005Metric
R46, R51, R76, R77: 100K/1%; R_0402_1005Metric
R48, R55, R69: 100R/1%; R_0402_1005Metric
R57: 75K/1%; R_0402_1005Metric
R60, R72: 4.7K/1%; R_0402_1005Metric
SW1, SW2: SW_Push; SW_Push_6x6x6
TP2, TP3, TP4, TP5, TP6, TP7, TP10, TP11, TP12, TP13: TestPoint; TestPoint_Pad_D1.5mm
U1, U2, U3, U4, U5: D3V3XA4B10LP; Diodes_UDFN-10_1.0x2.5mm_P0.5mm
U6: RTL8111H-CG-RH; QFN-32-1EP_4x4mm_P0.4mm_EP2.65x2.65mm
U9, U10, U11, U12, U17: ULC0524P; Diodes_UDFN-10_1.0x2.5mm_P0.5mm
U14: USB PD等快充协议受电芯片-CH224K-ESSOP10; ESSOP-10-1EP_3.9x5mm_P1.0mm_EP3.2x2.3
U15, U16: LM2734X; TSOT-23-6
Y1: 25MHz; Crystal_SMD_3225-4Pin_3.2x2.5mm

Connections:
5V_HDMI_VCC: C25.1, D4.1 (K), F1.1, R15.1, R18.1
+1V0: C33.2, C34.2, C35.2, C36.2, C40.2, C44.2, U6.3 (AVDD10), U6.8 (AVDD10), U6.22 (DVDD10), U6.24 (REGOUT), U6.30 (AVDD10)
+3V3: C37.2, C41.2, C45.2, C51.2, C52.2, C53.2, C54.2, C57.2, C58.2, C59.2, C60.2, C73.1, C75.1, C77.1, C79.1, C81.1, C83.1, D9.2 (A), J13.1, J13.2, J13.3, J13.4, J14.1, J14.2, J14.3, J15.2 (3.3V), J15.4 (3.3V), J15.12 (3.3V), J15.14 (3.3V), J15.16 (3.3V), J15.18 (3.3V), J15.70 (3.3V), J15.72 (3.3V), J15.74 (3.3V), J16.2 (3.3V), J16.4 (3.3V), J16.72 (3.3V), J16.74 (3.3V), J21.1, J21.2, J21.3, J21.4, L2.2, Q1.1 (G), Q2.1 (G), Q3.1 (G), R3.1, R4.1, R5.1, R20.2, R21.2, R24.2, R25.2, R34.2, R35.2, R52.1, R59.2, TP6.1 (1_1), U6.11 (AVDD33), U6.23 (VDDREG), U6.32 (AVDD33)
+5V: C30.2, C31.2, C32.2, C74.1, C76.1, C78.1, C80.1, C82.1, C84.1, D4.2 (A), D26.1 (K), F2.1, F3.1, F4.1, F5.1, L1.2, M1.2 (+), R57.2, R72.1, TP5.1 (1_1)
+12V: D15.2 (A), D16.2 (A), D17.2 (A), J17.1, TP4.1 (1_1)
+15V: D12.1 (K), D18.2 (A), D19.2 (A), D20.2 (A), J18.A4 (VBUS), J18.A9 (VBUS), J18.B4 (VBUS), J18.B9 (VBUS), R36.1, R37.1, TP3.1 (1_1)
+BATT: A1.115 (VBAT), R1.2
/Fan/FAN_1_PWM: A1.2 (FAN1_PWM), R69.1, TP12.1 (1_1)
/Fan/FAN_1_TAC: A1.4 (FAN1_TAC), R68.1, TP11.1 (1_1)
/GPIO/GPP_D0: A1.128 (GPP_D0), J19.1, U17.1, U17.10 (NC)
/GPIO/GPP_D1: A1.130 (GPP_D1), J19.2, U17.2, U17.9 (NC)
/GPIO/GPP_D2: A1.132 (GPP_D2), J19.3, U17.4, U17.7 (NC)
/GPIO/GPP_D3: A1.134 (GPP_D3), J19.4, U17.5, U17.6 (NC)
/GPIO/I2C2_SCL: A1.154 (I2C2_SCL), J9.1, U11.1, U11.10 (NC)
/GPIO/I2C2_SDA: A1.156 (I2C2_SDA), J7.1, U9.1, U9.10 (NC)
/GPIO/I2C3_SCL: A1.150 (I2C3_SCL), J9.2, U11.2, U11.9 (NC)
/GPIO/I2C3_SDA: A1.152 (I2C3_SDA), J7.2, U9.2, U9.9 (NC)
/GPIO/I2C4_SCL: A1.146 (I2C4_SCL), J9.3, U11.4, U11.7 (NC)
/GPIO/I2C4_SDA: A1.148 (I2C4_SDA), J7.3, U9.4, U9.7 (NC)
/GPIO/I2C5_SCL: A1.142 (I2C5_SCL), J9.4, U11.5, U11.6 (NC)
/GPIO/I2C5_SDA: A1.144 (I2C5_SDA), J7.4, U9.5, U9.6 (NC)
/GPIO/SOC_UART0_RX: A1.137 (UART0_RXD), J8.1, U10.1, U10.10 (NC)
/GPIO/SOC_UART0_TX: A1.139 (UART0_TXD), J10.1, U12.1, U12.10 (NC)
/GPIO/SOC_UART1_RX: A1.141 (UART1_RXD), J8.2, U10.2, U10.9 (NC)
/GPIO/SOC_UART1_TX: A1.143 (UART1_TXD), J10.2, U12.2, U12.9 (NC)
/GPIO/SOC_UART2_RX: A1.140 (UART2_RXD), J8.3, U10.4, U10.7 (NC)
/GPIO/SOC_UART2_TX: A1.138 (UART2_TXD), J10.3, U12.4, U12.7 (NC)
/Gigabit Ethernet/GbE_PCIe_CLK+: A1.94 (REFCLK4+), U6.15 (REFCLK_P)
/Gigabit Ethernet/GbE_PCIe_CLK-: A1.96 (REFCLK4-), U6.16 (REFCLK_N)
/Gigabit Ethernet/GbE_PCIe_RX+: A1.64 (HSIO6_RX+), C43.2
/Gigabit Ethernet/GbE_PCIe_RX-: A1.66 (HSIO6_RX-), C39.2
/Gigabit Ethernet/GbE_PCIe_TX+: A1.61 (HSIO6_TX+), C42.2
/Gigabit Ethernet/GbE_PCIe_TX-: A1.63 (HSIO6_TX-), C38.2
/Gigabit Ethernet/HSI+: C42.1, U6.13 (HSIP)
/Gigabit Ethernet/HSI-: C38.1, U6.14 (HSIN)
/Gigabit Ethernet/HSO+: C43.1, U6.17 (HSOP)
/Gigabit Ethernet/HSO-: C39.1, U6.18 (HSON)
/Gigabit Ethernet/MDI0+: J6.R2 (TD1+), U6.1 (MDIP0)
/Gigabit Ethernet/MDI0-: J6.R3 (TD1-), U6.2 (MDIN0)
/Gigabit Ethernet/MDI1+: J6.R4 (TD2+), U6.4 (MDIP1)
/Gigabit Ethernet/MDI1-: J6.R5 (TD2-), U6.5 (MDIN1)
/Gigabit Ethernet/MDI2+: J6.R6 (TD3+), U6.6 (MDIP2)
/Gigabit Ethernet/MDI2-: J6.R7 (TD3-), U6.7 (MDIN2)
/Gigabit Ethernet/MDI3+: J6.R8 (TD4+), U6.9 (MDIP3)
/Gigabit Ethernet/MDI3-: J6.R9 (TD4-), U6.10 (MDIN3)
/HDMI/DDC_SCL: D1.2 (A2), J3.15 (SCL), Q2.2 (S), R15.2
/HDMI/DDC_SDA: D3.2 (A2), J3.16 (SDA), Q3.2 (S), R18.2
/HDMI/DDI_B_DDC_SCL: A1.171 (DDIB_DDC_SCL), Q2.3 (D), R5.2
/HDMI/DDI_B_DDC_SDA: A1.169 (DDIB_DDC_SDA), Q3.3 (D), R3.2
/HDMI/DDI_B_HPD: A1.183 (DDIB_HPD), Q1.3 (D), R4.2
/HDMI/DDI_B_TX0+: A1.217 (DDIB_TX0+), C17.1
/HDMI/DDI_B_TX0-: A1.215 (DDIB_TX0-), C18.1
/HDMI/DDI_B_TX1+: A1.211 (DDIB_TX1+), C19.1
/HDMI/DDI_B_TX1-: A1.209 (DDIB_TX1-), C20.1
/HDMI/DDI_B_TX2+: A1.205 (DDIB_TX2+), C21.1
/HDMI/DDI_B_TX2-: A1.203 (DDIB_TX2-), C22.1
/HDMI/DDI_B_TX3+: A1.199 (DDIB_TX3+), C23.1
/HDMI/DDI_B_TX3-: A1.197 (DDIB_TX3-), C24.1
/HDMI/HPD: D2.2 (A2), J3.19 (HPD), R11.2
/HDMI/TMDS_CK+: C23.2, J3.10 (CK+), R8.2, U2.4, U2.7 (NC)
/HDMI/TMDS_CK-: C24.2, J3.12 (CK-), R7.2, U2.5, U2.6 (NC)
/HDMI/TMDS_D0+: C21.2, J3.7 (D0+), R10.2, U2.1, U2.10 (NC)
/HDMI/TMDS_D0-: C22.2, J3.9 (D0-), R9.2, U2.2, U2.9 (NC)
/HDMI/TMDS_D1+: C19.2, J3.4 (D1+), R14.2, U1.4, U1.7 (NC)
/HDMI/TMDS_D1-: C20.2, J3.6 (D1-), R13.2, U1.5, U1.6 (NC)
/HDMI/TMDS_D2+: C17.2, J3.1 (D2+), R17.2, U1.1, U1.10 (NC)
/HDMI/TMDS_D2-: C18.2, J3.3 (D2-), R16.2, U1.2, U1.9 (NC)
/LattePanda Module/HSIO_0_TX+: A1.13 (HSIO0_TX+), C27.1
/LattePanda Module/HSIO_0_TX-: A1.15 (HSIO0_TX-), C26.1
/LattePanda Module/HSIO_1_TX+: A1.19 (HSIO1_TX+), C29.1
/LattePanda Module/HSIO_1_TX-: A1.21 (HSIO1_TX-), C28.1
/LattePanda Module/HSIO_2_RX+: A1.28 (HSIO2_RX+), J15.43 (PERp0/SATA-B-)
/LattePanda Module/HSIO_2_RX-: A1.30 (HSIO2_RX-), J15.41 (PERn0/SATA-B+)
/LattePanda Module/HSIO_2_TX+: A1.25 (HSIO2_TX+), C49.1
/LattePanda Module/HSIO_2_TX-: A1.27 (HSIO2_TX-), C50.1
/LattePanda Module/HSIO_3_RX+: A1.34 (HSIO3_RX+), J16.41 (PERp0)
/LattePanda Module/HSIO_3_RX-: A1.36 (HSIO3_RX-), J16.43 (PERn0)
/LattePanda Module/HSIO_3_TX+: A1.31 (HSIO3_TX+), C55.1
/LattePanda Module/HSIO_3_TX-: A1.33 (HSIO3_TX-), C56.1
/LattePanda Module/REFCLK0+: A1.85 (REFCLK0+), J15.55 (REFCLKp)
/LattePanda Module/REFCLK0-: A1.87 (REFCLK0-), J15.53 (REFCLKn)
/LattePanda Module/REFCLK3+: A1.88 (REFCLK3+), J16.47 (REFCLKp0)
/LattePanda Module/REFCLK3-: A1.90 (REFCLK3-), J16.49 (REFCLKn0)
/LattePanda Module/SLS_S3: A1.7 (SLS_S3), JP1.3 (B)
/LattePanda Module/SUSCKL_WIFI: A1.131 (SUSCLK), R29.1, R33.2
/LattePanda Module/USB_2_P7+: A1.76 (USB2_P7+), J16.3 (USB_D+)
/LattePanda Module/USB_2_P7-: A1.78 (USB2_P7-), J16.5 (USB_D-)
/LattePanda Module/~PWR_SW: A1.1 (~PWRBTN), R48.1
/LattePanda Module/~RST_SW: A1.3 (~RSTBTN), R55.1
/M.2 M Key/CON_PCIE_TX0+: C55.2, J16.35 (PETp0)
/M.2 M Key/CON_PCIE_TX0-: C56.2, J16.37 (PETn0)
/M.2 M Key/CON_PCIE_TX1+: C49.2, J15.49 (PETp0/SATA-A+)
/M.2 M Key/CON_PCIE_TX1-: C50.2, J15.47 (PETn0/SATA-A-)
/M.2 M Key/~CLKREQE: J16.53 (~CLKREQ0), R32.1
/M.2 M Key/~CLKREQM: J15.52 (~CLKREQ), R27.1
/Power Supply/CC1: D13.1 (K), J18.A5 (CC1), U14.7 (CC1)
/Power Supply/CC2: D14.1 (K), J18.B5 (CC2), U14.6 (CC2)
/Power Supply/PWR_C_D+: D11.2 (A2), J18.A6 (D+), J18.B6 (D+), U14.4 (DP)
/Power Supply/PWR_C_D-: D10.2 (A2), J18.A7 (D-), J18.B7 (D-), U14.5 (DM)
/Power Supply/PWR_EN: R46.1, R51.2, U15.4 (EN), U16.4 (EN)
/USB 2.0 & 3.0/CON_USB1_D_N: A1.109 (USB2_P5-), J5.2 (D1-), U4.2, U4.9 (NC)
/USB 2.0 & 3.0/CON_USB1_D_P: A1.111 (USB2_P5+), J5.3 (D1+), U4.1, U4.10 (NC)
/USB 2.0 & 3.0/CON_USB2_D_N: A1.79 (USB2_P3-), J5.6 (D2-), U4.5, U4.6 (NC)
/USB 2.0 & 3.0/CON_USB2_D_P: A1.81 (USB2_P3+), J5.7 (D2+), U4.4, U4.7 (NC)
/USB 2.0 & 3.0/CON_USB3_D_N: A1.73 (USB2_P2-), D8.1 (A1), J4.2 (D1-)
/USB 2.0 & 3.0/CON_USB3_D_P: A1.75 (USB2_P2+), D7.1 (A1), J4.3 (D1+)
/USB 2.0 & 3.0/CON_USB3_SSRX_N: A1.18 (HSIO0_RX-), J4.5 (SSRX1-), U5.4, U5.7 (NC)
/USB 2.0 & 3.0/CON_USB3_SSRX_P: A1.16 (HSIO0_RX+), J4.6 (SSRX1+), U5.5, U5.6 (NC)
/USB 2.0 & 3.0/CON_USB3_SSTX_N: C26.2, J4.8 (SSTX1-), U3.1, U3.10 (NC)
/USB 2.0 & 3.0/CON_USB3_SSTX_P: C27.2, J4.9 (SSTX1+), U3.2, U3.9 (NC)
/USB 2.0 & 3.0/CON_USB4_D_N: A1.67 (USB2_P1-), D6.1 (A1), J4.11 (D2-)
/USB 2.0 & 3.0/CON_USB4_D_P: A1.69 (USB2_P1+), D5.1 (A1), J4.12 (D2+)
/USB 2.0 & 3.0/CON_USB4_SSRX_N: A1.24 (HSIO1_RX-), J4.14 (SSRX2-), U5.1, U5.10 (NC)
/USB 2.0 & 3.0/CON_USB4_SSRX_P: A1.22 (HSIO1_RX+), J4.15 (SSRX2+), U5.2, U5.9 (NC)
/USB 2.0 & 3.0/CON_USB4_SSTX_N: C28.2, J4.17 (SSTX2-), U3.4, U3.7 (NC)
/USB 2.0 & 3.0/CON_USB4_SSTX_P: C29.2, J4.18 (SSTX2+), U3.5, U3.6 (NC)
/~PLT_RST: A1.105 (~PLTRST), J15.50 (~PERST), J16.52 (~PERST0), U6.19 (PERSTB)
/~PWR_LED/~PSON: A1.5 (SLS_S0), JP1.1 (A), R19.1, R47.2
/~WAKE: A1.103 (~WAKE), J15.54 (~PEWAKE), J16.55 (~PEWAKE0)
GND: A1.11 (GND), A1.14 (GND), A1.17 (GND), A1.20 (GND), A1.23 (GND), A1.26 (GND), A1.29 (GND), A1.32 (GND), A1.35 (GND), A1.38 (GND), A1.41 (GND), A1.44 (GND), A1.47 (GND), A1.50 (GND), A1.53 (GND), A1.56 (GND), A1.59 (GND), A1.62 (GND), A1.65 (GND), A1.68 (GND), A1.71 (GND), A1.74 (GND), A1.77 (GND), A1.80 (GND), A1.83 (GND), A1.86 (GND), A1.89 (GND), A1.92 (GND), A1.95 (GND), A1.98 (GND), A1.101 (GND), A1.107 (GND), A1.110 (GND), A1.113 (GND), A1.116 (GND), A1.135 (GND), A1.136 (GND), A1.151 (GND), A1.158 (GND), A1.167 (GND), A1.170 (GND), A1.181 (GND), A1.182 (GND), A1.188 (GND), A1.189 (GND), A1.194 (GND), A1.195 (GND), A1.200 (GND), A1.201 (GND), A1.206 (GND), A1.207 (GND), A1.212 (GND), A1.213 (GND), A1.218 (GND), A1.219 (GND), A1.224 (GND), A1.225 (GND), A1.230 (GND), A1.231 (GND), A1.236 (GND), A1.237 (GND), A1.242 (GND), A1.243 (GND), A1.248 (GND), A1.249 (GND), A1.MP (Mountinge_Pads), BT1.2 (-), C25.2, C30.1, C31.1, C32.1, C33.1, C34.1, C35.1, C36.1, C37.1, C40.1, C41.1, C44.1, C45.1, C46.2, C47.2, C48.1, C51.1, C52.1, C53.1, C54.1, C57.1, C58.1, C59.1, C60.1, C61.1, C64.1, C65.2, C66.2, C67.1, C68.2, C69.2, C74.2, C75.2, C76.2, C77.2, C78.2, C79.2, C80.2, C81.2, C82.2, C83.2, C84.2, D1.1 (A1), D2.1 (A1), D3.1 (A1), D5.2 (A2), D6.2 (A2), D7.2 (A2), D8.2 (A2), D10.1 (A1), D11.1 (A1), D12.2 (A), D13.2 (A), D14.2 (A), D21.2 (A2), D24.2 (A), D25.2 (A2), H1.1 (1_1), H2.1 (1_1), H3.1 (1_1), H4.1 (1_1), H5.1 (1_1), H6.1 (1_1), H7.1 (1_1), H8.1 (1_1), J1.3, J3.2 (D2S), J3.5 (D1S), J3.8 (D0S), J3.11 (CKS), J3.17 (GND), J3.SH, J4.4 (GND1), J4.7 (DRAIN1), J4.13 (GND2), J4.16 (DRAIN2), J4.19 (SHIELD), J5.4 (GND1), J5.8 (GND2), J5.9 (Shield), J6.R10 (GND), J6.SH, J11.1, J11.2, J11.3, J12.1, J12.2, J12.3, J12.4, J15.1 (GND), J15.3 (GND), J15.9 (GND), J15.15 (GND), J15.21 (GND), J15.27 (GND), J15.33 (GND), J15.39 (GND), J15.45 (GND), J15.51 (GND), J15.57 (GND), J15.71 (GND), J15.73 (GND), J15.75 (GND), J16.1 (GND), J16.7 (GND), J16.18 (GND), J16.33 (GND), J16.39 (GND), J16.45 (GND), J16.51 (GND), J16.57 (GND), J16.63 (GND), J16.69 (GND), J16.75 (GND), J17.2, J17.3, J18.A1 (GND), J18.A12 (GND), J18.B1 (GND), J18.B12 (GND), J18.S1 (SHIELD), J20.1, J20.2, J20.3, J20.4, M1.1 (-), Q4.2 (S), Q8.2 (S), R6.2, R22.2, R27.2, R32.2, R43.2, R49.2, R51.1, R58.1, R60.1, R76.2, R77.2, R78.1, R79.1, SW1.2, SW2.2, U1.3 (VSS), U1.8 (VSS), U2.3 (VSS), U2.8 (VSS), U3.3 (VSS), U3.8 (VSS), U4.3 (VSS), U4.8 (VSS), U5.3 (VSS), U5.8 (VSS), U6.33 (GND), U9.3 (VSS), U9.8 (VSS), U10.3 (VSS), U10.8 (VSS), U11.3 (VSS), U11.8 (VSS), U12.3 (VSS), U12.8 (VSS), U14.0 (GND), U15.2 (GND), U16.2 (GND), U17.3 (VSS), U17.8 (VSS), Y1.2, Y1.4
unnamed: A1.12 (SIO_UART_RX), J1.2
unnamed: A1.10 (SIO_UART_TX), J1.1
unnamed: A1.187 (TCP0_HPD), R76.1
unnamed: A1.185 (TCP1_HPD), R77.1
unnamed: A1.133 (~BIOS_SEL), R2.1, TP7.1 (1_1)
unnamed: A1.100 (~CLKREQ3), R79.2
unnamed: A1.102 (~CLKREQ4), R78.2
unnamed: BT1.1 (+), R1.1
unnamed: D9.1 (K), J15.10 (DAS/~DSS/~LED1)
unnamed: C66.1, D21.1 (A1), R48.2, SW1.1
unnamed: D22.2 (A), R52.2
unnamed: D22.1 (K), Q8.3 (D)
unnamed: C69.1, D25.1 (A1), R55.2, SW2.1
unnamed: D26.2 (A), M1.3 (Tacho), R68.2, R72.2
unnamed: F1.2, J3.18 (+5V)
unnamed: F4.2, J4.1 (VBUS1)
unnamed: F5.2, J4.10 (VBUS2)
unnamed: F2.2, J5.1 (VBUS1)
unnamed: F3.2, J5.5 (VBUS2)
unnamed: C48.2, J6.R1 (CT)
unnamed: J6.L1, R25.1
unnamed: J6.L3, R24.1
unnamed: J15.38 (DEVSLP), TP2.1 (1_1)
unnamed: J15.68 (SUSCLK), R29.2
unnamed: J16.50 (SUSCLK), R33.1
unnamed: J16.56 (~W_DISABLE1), R34.1
unnamed: J16.54 (~W_DISABLE2), R35.1
unnamed: JP1.2 (C), R46.2
unnamed: M1.4 (PWM), R69.2
unnamed: Q1.2 (S), R6.1, R11.1
unnamed: Q4.3 (D), R7.1, R8.1, R9.1, R10.1, R13.1, R14.1, R16.1, R17.1
unnamed: Q4.1 (G), R19.2
unnamed: Q8.1 (G), R47.1, R49.1
unnamed: C47.1, R23.1, U6.28 (CKXTAL1), Y1.1
unnamed: C46.1, R23.2, U6.29 (CKXTAL2), Y1.3
unnamed: R20.1, U6.20 (ISOLATEB)
unnamed: R21.1, U6.21 (LANWAKEB)
unnamed: J6.L4, U6.26 (LED1)
unnamed: J6.L2, U6.25 (LED2)
unnamed: R22.1, U6.31 (RSET)
unnamed: U10.5, U10.6 (NC)
unnamed: U12.5, U12.6 (NC)
unnamed: R43.1, U14.9 (CFG1)
unnamed: R36.2, U14.8 (VBUS)
unnamed: C61.2, R37.2, U14.1 (VDD)
unnamed: C70.2, U15.1 (BOOST)
unnamed: R57.1, R58.2, U15.3 (FB)
unnamed: C70.1, L1.1, U15.6 (SW)
unnamed: C71.2, U16.1 (BOOST)
unnamed: C73.2, R59.1, R60.2, U16.3 (FB)
unnamed: C71.1, L2.1, U16.6 (SW)
VDC: A1.250 (VIN), A1.251 (VIN), A1.252 (VIN), A1.253 (VIN), A1.254 (VIN), A1.255 (VIN), A1.256 (VIN), A1.257 (VIN), A1.258 (VIN), A1.259 (VIN), A1.260 (VIN), C64.2, C65.1, C67.2, C68.1, D15.1 (K), D16.1 (K), D17.1 (K), D18.1 (K), D19.1 (K), D20.1 (K), R53.2, TP10.1 (1_1), U15.5 (VIN), U16.5 (VIN)
VPullup: D24.1 (K), R2.2, R53.1, TP13.1 (1_1)
