gorkemguven/LattePanda-Mu-Lite-Custom-Carrier/(notices)

Notices in the files:
README.md:
License: MIT
